GadgetReboot/Rotary_USB/README.md

# Rotary_USB
LS30 to MAME Interface<BR><BR>
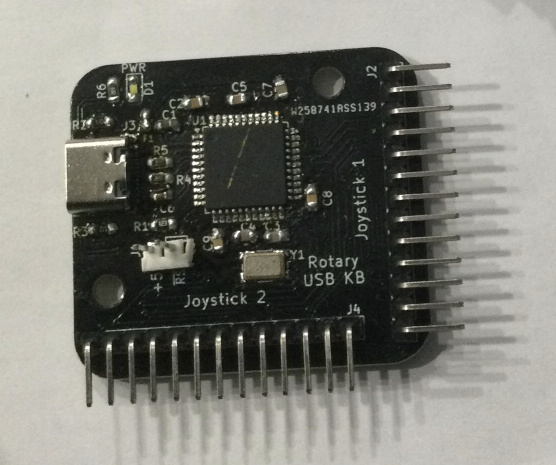
[picture p1: Assembled_PCB.jpg]
PCB
<br><br><BR><BR>
Uses an ATMega32u4 with a Sparkfun Pro Micro bootloader<br>
to read 1 or 2 rotary joysticks and send out a clockwise or counter-clockwise keystroke when movement occurs.
