GadgetReboot/Rotary_USB/Sch_Rotary_USB.pdf

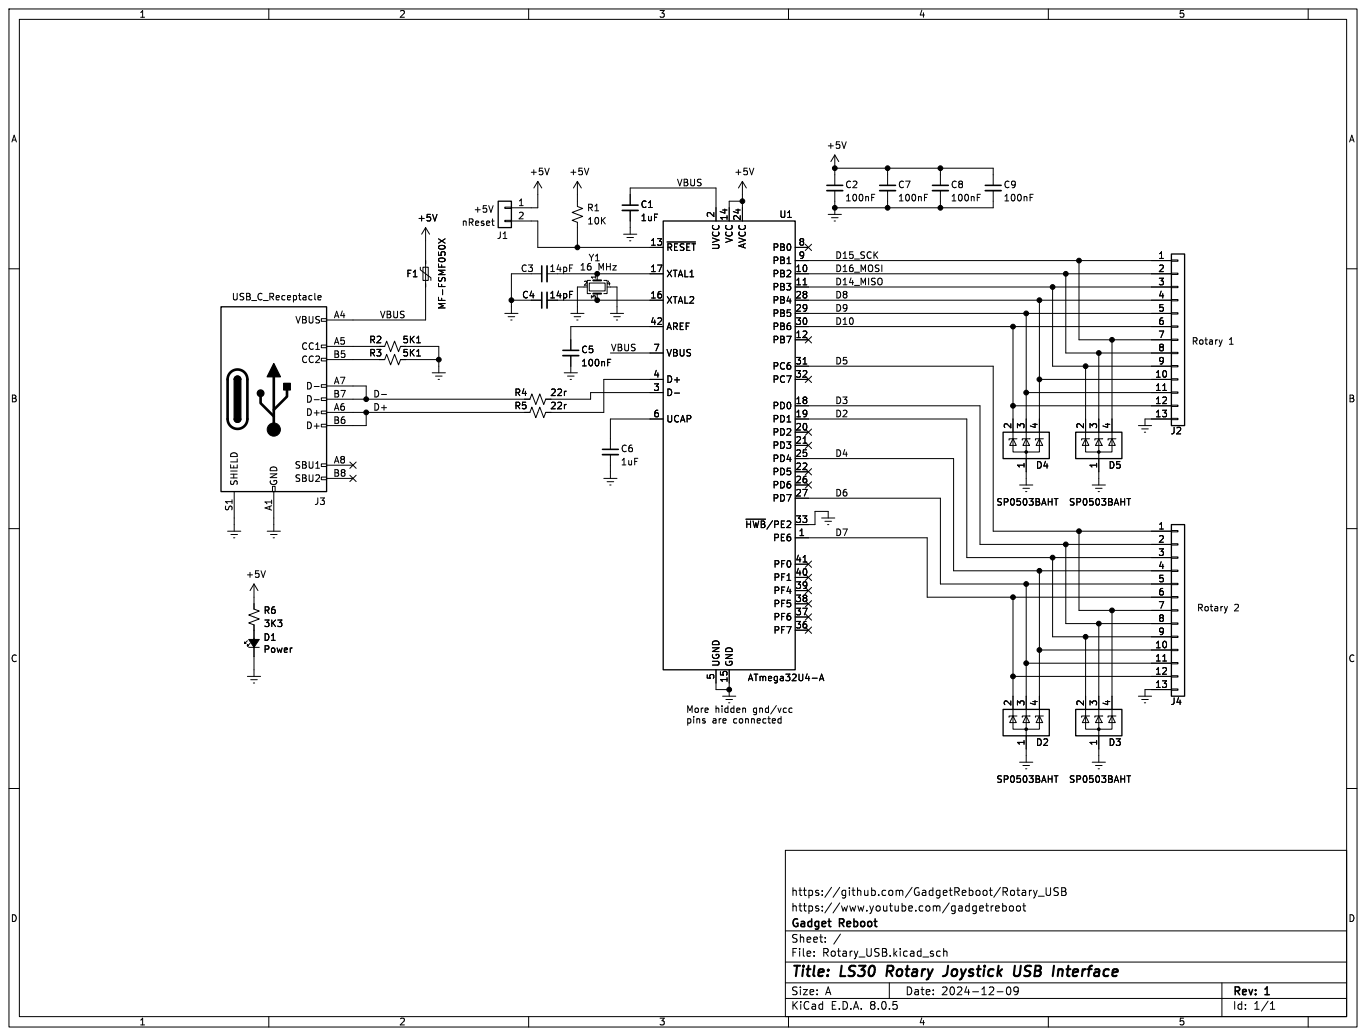
[picture p2: page 1]

2 PD2 20 PD3 21 PD5 22 AVCC 24 PD4 25 PD6 26 PD7 27 PB4 28 PB5 29 D- 3 PB6 30 PC6 31 PC7 32 ~{HWB}/PE233 PF7 36 PF6 37 PF5 38 PF4 39 D+ 4 PF1 40 PF0 41 AREF 42 UGND

https://github.com/GadgetReboot/Rotary_USB

Id: 1/1 Title: LS30 Rotary Joystick USB Interface
