GadgetReboot/Rotary_USB/KiCad/Rotary_USB.kicad_pcb

## KiCad design KiCad/Rotary_USB.kicad_pcb (2024-12-09)

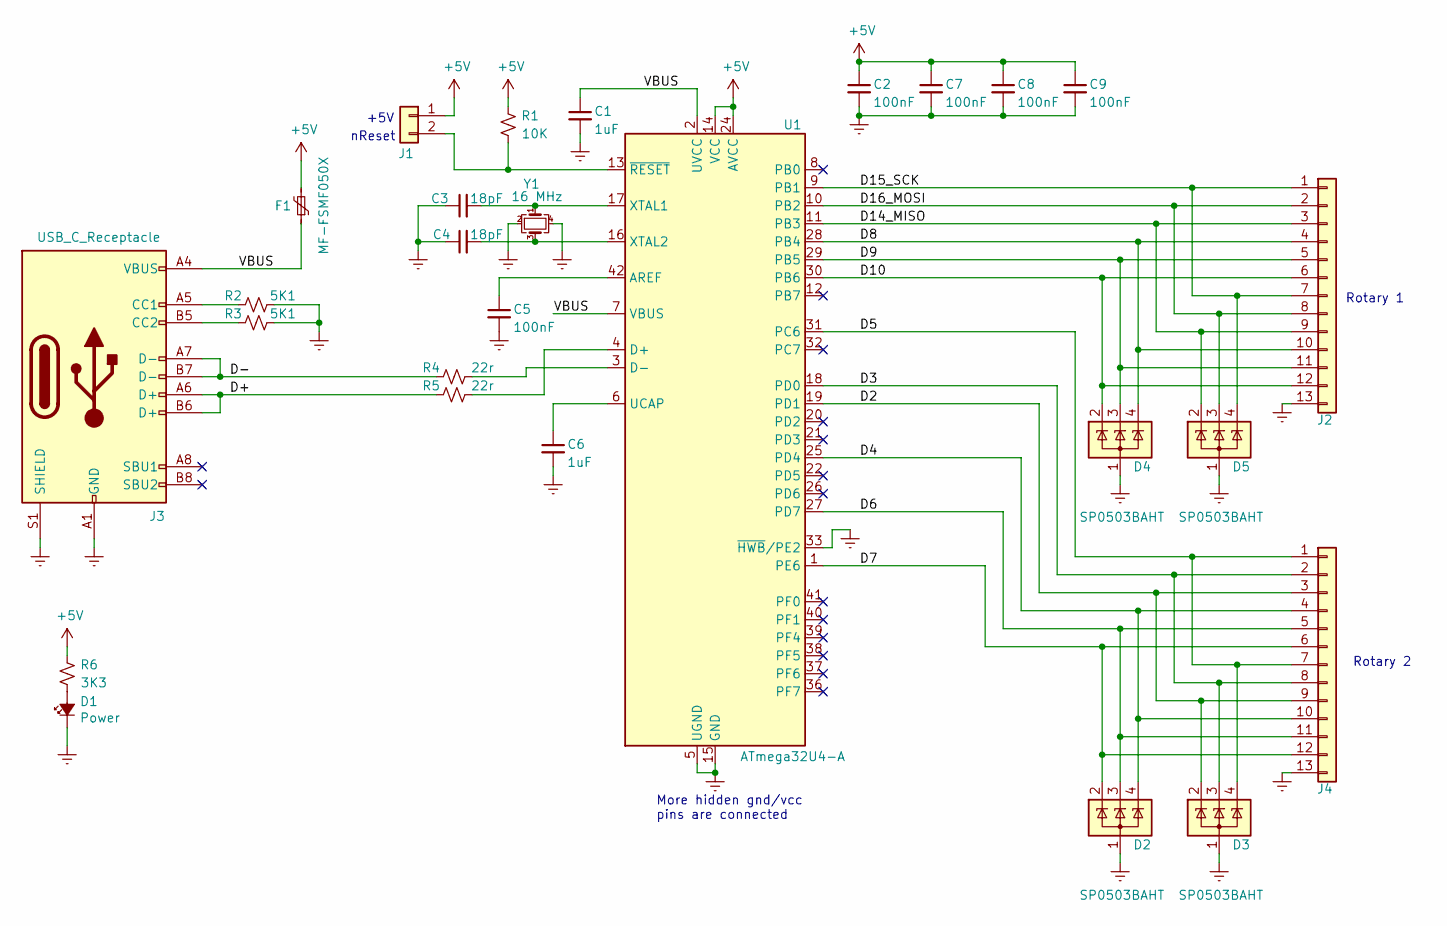
[picture p3: schematic Rotary_USB.kicad_sch, LS30 Rotary Joystick USB Interface]

Parts:
C1, C6: 1uF; C_0805_2012Metric
C2, C5, C7, C8, C9: 100nF; C_0805_2012Metric
C3, C4: 18pF; C_0805_2012Metric
D1: Power; LED_0805_2012Metric_Pad1.15x1.40mm_HandSolder
D2, D3, D4, D5: SP0503BAHT; SOT-143
F1: MF-FSMF050X; R_0603_1608Metric_Pad1.05x0.95mm_HandSolder
J1: Conn_01x02; PinHeader_1x02_P2.54mm_Vertical
J2, J4: Conn_01x13; PinHeader_1x13_P2.54mm_Vertical
J3: USB_C_Receptacle; USB_C_Receptacle_XKB_U262-16XN-4BVC11; Part # XKB Connectivity U262-161N-4BVC11
R1: 10K; R_0805_2012Metric_Pad1.20x1.40mm_HandSolder
R2, R3: 5K1; R_0805_2012Metric_Pad1.20x1.40mm_HandSolder
R4, R5: 22r; R_0805_2012Metric_Pad1.20x1.40mm_HandSolder
R6: 3K3; R_0805_2012Metric_Pad1.20x1.40mm_HandSolder
U1: ATmega32U4-A; TQFP-44_10x10mm_P0.8mm
Y1: 16 MHz; Crystal_SMD_Abracon_ABM3B-4Pin_5.0x3.2mm

Connections:
+5V: C2.1, C7.1, C8.1, C9.1, F1.2, J1.1, R1.1, R6.1, U1.14 (VCC), U1.24 (AVCC), U1.34 (VCC), U1.44 (AVCC)
/D2: D3.2 (K), J4.3, J4.9, U1.19 (PD1)
/D3: D3.3 (K), J4.2, J4.8, U1.18 (PD0)
/D4: D2.4 (K), J4.4, J4.10, U1.25 (PD4)
/D5: D3.4 (K), J4.1, J4.7, U1.31 (PC6)
/D6: D2.3 (K), J4.5, J4.11, U1.27 (PD7)
/D7: D2.2 (K), J4.6, J4.12, U1.1 (PE6)
/D8: D4.4 (K), J2.4, J2.10, U1.28 (PB4)
/D9: D4.3 (K), J2.5, J2.11, U1.29 (PB5)
/D10: D4.2 (K), J2.6, J2.12, U1.30 (PB6)
/D14_MISO: D5.2 (K), J2.3, J2.9, U1.11 (PB3)
/D15_SCK: D5.4 (K), J2.1, J2.7, U1.9 (PB1)
/D16_MOSI: D5.3 (K), J2.2, J2.8, U1.10 (PB2)
/D+: J3.A6 (D+), J3.B6 (D+), R5.2
/D-: J3.A7 (D-), J3.B7 (D-), R4.2
/VBUS: C1.1, F1.1, J3.A4 (VBUS), J3.A9 (VBUS), J3.B4 (VBUS), J3.B9 (VBUS), U1.2 (UVCC), U1.7 (VBUS)
GNDREF: C1.2, C2.2, C3.1, C4.1, C5.2, C6.2, C7.2, C8.2, C9.2, D1.1 (K), D2.1 (A), D3.1 (A), D4.1 (A), D5.1 (A), J2.13, J3.A1 (GND), J3.A12 (GND), J3.B1 (GND), J3.B12 (GND), J3.S1 (SHIELD), J4.13, R2.1, R3.1, U1.5 (UGND), U1.15 (GND), U1.23 (GND), U1.33 (~HWB/PE2), U1.35 (GND), U1.43 (GND), Y1.2, Y1.4
unnamed: D1.2 (A), R6.2
unnamed: J1.2, R1.2, U1.13 (~RESET)
unnamed: J3.A5 (CC1), R2.2
unnamed: J3.B5 (CC2), R3.2
unnamed: C5.1, U1.42 (AREF)
unnamed: R5.1, U1.4 (D+)
unnamed: R4.1, U1.3 (D-)
unnamed: C6.1, U1.6 (UCAP)
unnamed: C3.2, U1.17 (XTAL1), Y1.1
unnamed: C4.2, U1.16 (XTAL2), Y1.3

Notes on the sheet:
More hidden gnd/vcc pins are connected
nReset
Rotary 1
+5V
Rotary 2

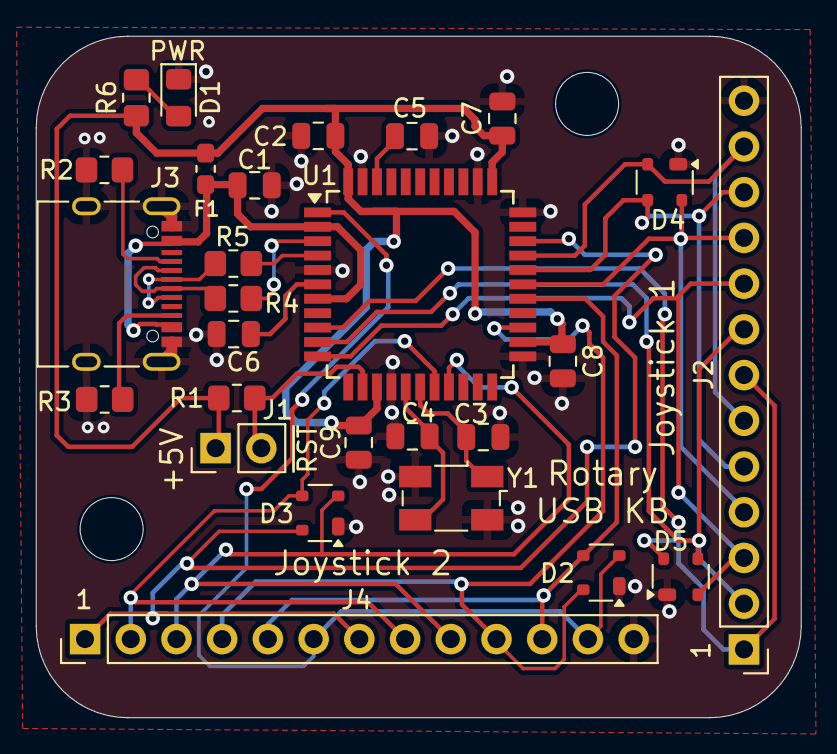
[picture p4: board Rotary_USB.kicad_pcb from above]

Board: 2 copper layers, 42.5 x 37.9 mm, 27 parts (0 on the bottom side), 27 nets.
